21st-BIO/starlet-accessories/plate_stacker.stl

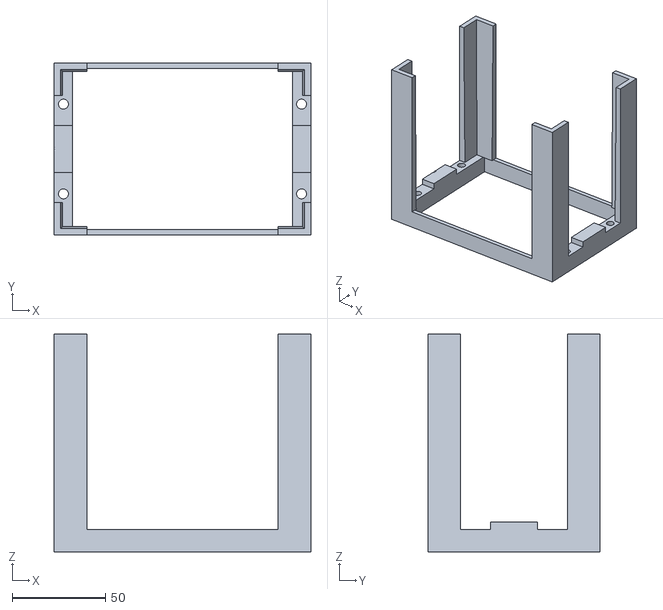
[picture p1: CAD file, 2026-11-05]
plate_stacker.stl
138.2 x 92.5 x 117.0
