21st-BIO/starlet-accessories/pcr_plate_adapter_72_1979.stl

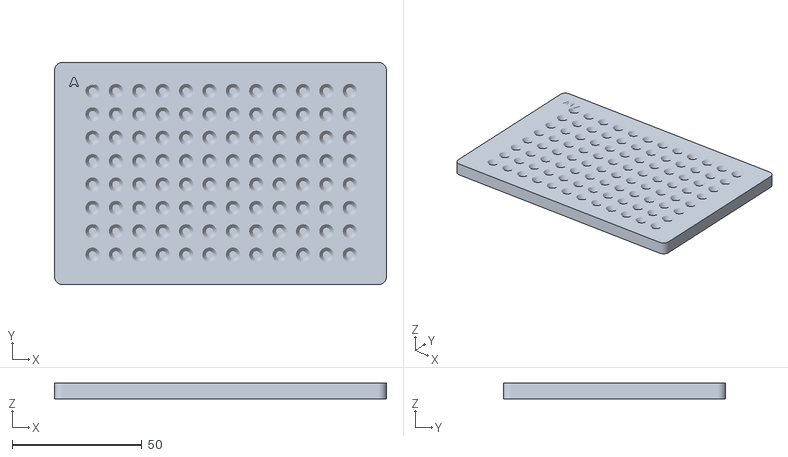
[picture p2: CAD file, 2026-11-05]
pcr_plate_adapter_72_1979.stl
127.8 x 85.5 x 6.00
