21st-BIO/starlet-accessories/vacuum_manifold_adapter.stl

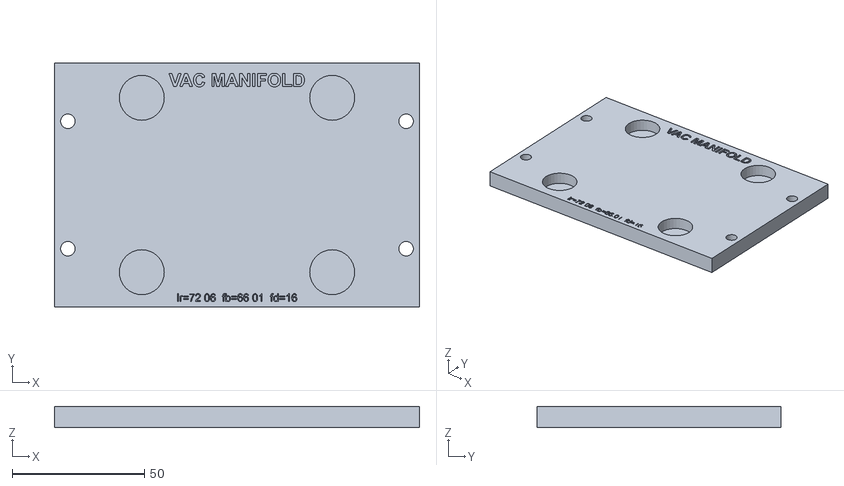
[picture p3: CAD file, 2026-11-05]
vacuum_manifold_adapter.stl
138.1 x 92.5 x 8.00
