21st-BIO/starlet-accessories/carrier_module_spring.stl

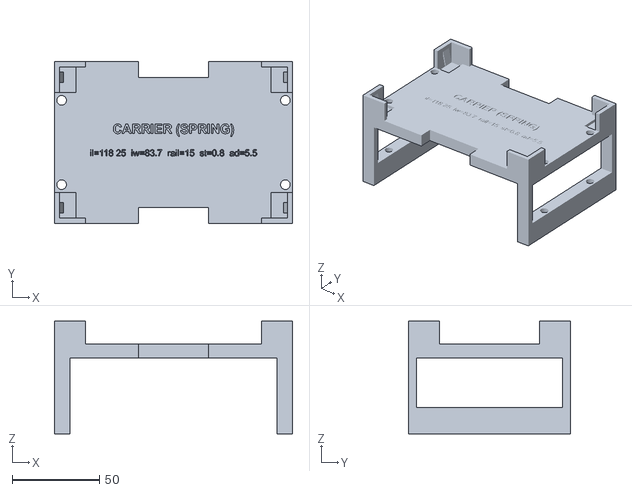
[picture p4: CAD file, 2026-11-05]
carrier_module_spring.stl
136.2 x 92.5 x 64.6
