21st-BIO/starlet-accessories/(list of files, cad)

Other CAD files:
balance_base_front.scad
carrier_module_spring.scad
