21st-BIO/starlet-accessories/(commit log)

2026-10-02 Initial commit — Hamilton STARlet accessories
    Balance base (OHAUS Navigator), plate carrier module (spring + non-spring),
    plate stacker, tip waste chute, barcode scanner holder, and Q-tray adapter
    template. Test pieces in tests/.
    [balance_base_back.scad, balance_base_finger_test.scad, balance_base_fork_test.scad, balance_base_front.scad, carrier_module.scad, carrier_module_rail_test.scad, carrier_module_spring.scad, plate_stacker.scad]
2026-10-02 Redesign qtray_adapter as vacuum manifold adapter
    Replaced L-post corner locators with rubber-foot pockets (same approach as
    balance base). Four counterbored recesses receive the manifold's corner feet,
    locating it precisely in X and Y. Added 1cm engraved alignment grid on top
    surface. Dimensions estimated from ruler photos — foot_d, foot_lr, foot_fb
    marked as TODO for caliper verification before printing.
    [qtray_adapter.scad]
2026-10-02 Add vacuum manifold carrier adapter; restore Q-tray as torpedo-finger template
    vacuum_manifold_adapter.scad: flat plate that bolts into any Hamilton carrier
    frame using the same 4-screw pattern as the plate carrier module bottom rail
    (screw_lc=128mm x screw_wc=48.25mm). Four recessed pockets on top locate the
    manifold rubber feet. Plate auto-sizes to always contain the foot pockets even
    if the manifold overhangs the carrier sides. All foot dimensions marked TODO
    pending caliper measurement.
    qtray_adapter.scad: restored to a clean torpedo-finger platform template with
    corner L-posts for the Q-tray (separate item from the manifold). tray_l/tray_w/
    n_fingers all marked TODO for caliper measure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
    [qtray_adapter.scad, vacuum_manifold_adapter.scad]
2026-10-02 Update manifold adapter with caliper-measured foot dimensions
    foot_h = 5.75mm (photo 3)
    foot_lr = 72.06mm (photo 2, along carrier length)
    foot_fb = 66.01mm (photo 4, along carrier width)
    foot_d = 16.0mm (estimated from photos, still needs caliper check)
    Both foot spacings fit within the standard carrier frame (138.15 x 92.50mm)
    so the plate body stays at carrier dimensions with no overhang.
    [vacuum_manifold_adapter.scad]
2026-10-02 Confirm foot_d = 16mm — all dimensions now measured/confirmed
    [vacuum_manifold_adapter.scad]
2026-11-02 Add PCR plate adapter for Sarstedt 72.1979
    SBS-footprint adapter (127.76 x 85.48 mm, 4.5 mm thick) with 96 conical
    guide holes at 9 mm pitch. Wide opening (5.5 mm) at the top surface narrows
    to 2.8 mm — PCR plate's V-bottom cones self-centre as the plate is lowered
    from above, removing the manual push-right step before HHS clamping.
    Well grid: A1 at 14.66/74.48 mm in adapter space, derived from measured
    plate dimensions (126.1 x 86.0 mm, a1_xl=13.0, a1_yr=11.0 mm).
    External cone geometry estimated from inner well measurements; cone_top_d
    and cone_bot_d are tunable if fit is poor.
2026-11-03 pcr_plate_adapter: solid bottom (blind guide holes)
    Remove the through-hole cylinder from guide_hole() so the conical
    recesses are blind — 3 mm solid floor beneath the cone tips.
    Increase base_h from 4.5 to 6.0 mm to give enough material under
    the cones. Update README to match.
2026-11-03 pcr_plate_adapter: add version label to underside
    Add version variable (v1.1) and include it in the engraved
    underside text so printed parts can be identified at a glance.
    Increment version when geometry changes.
2026-11-03 carrier_module_spring: narrow outer_w by 1 mm/side (92.5 -> 90.5)
    Third iteration of side clearance reduction. Screw holes (screw_wc=48.25)
    remain unchanged — 18.4 mm of material outside each hole at the new width.
2026-11-03 carrier_module_spring: trim end_wall 9.95→8.95mm for adjacent-carrier clearance
    Reduces module length from 138.15 to 136.15mm (1mm off each short end).
    outer_w stays 92.50mm; screw hole Y-positions unchanged (48.25mm c-t-c).
    Screw holes move 1mm closer to each outer face (wall: 2.3→1.3mm).
2026-11-03 carrier_module_rail_test: sync end_wall 9.95→8.95mm
2026-11-05 carrier_module_spring: reduce tab_wall 3.50→3.00mm for SBS plate clearance
    Previous tab_wall=3.50 left only 0.02mm pocket clearance over SBS plate width
    (85.48mm), printing tight. 3.00mm gives 86.5mm pocket — 0.5mm/side clearance.
    outer_w unchanged at 92.50mm; screw hole positions unaffected.
2026-11-05 Add rendered STLs for production parts
    carrier_module_spring.stl: end_wall=8.95mm, tab_wall=3.00mm (SBS-compatible pocket 86.5mm)
    plate_stacker.stl, pcr_plate_adapter_72_1979.stl, vacuum_manifold_adapter.stl: initial renders
